educoay/Scoreboard/README.md

# Scoreboard
Arduino powered scoreboard with wired controller

**The wireless branch is newer and currently used in the application**
