educoay/Scoreboard/Scoreboard/README.md

# SCOREBOARD project
### 7-segments diplays scoreboard with wired controller 
**version 1.0.5**

This project is made of a single main C++ file, which will be compiled for Arduino AVR 
architecture, and control a scoreboard with 7-segments display and voltage analog input.
A real application has been developed with this library, showing the score and time in a 
basketball match for a local team. 
Documentation pdf format regarding realization and software can be found in the Doc folder.
Some pictures are at
https://plus.google.com/photos/109652469005118520122/albums/5799213099932281809
