educoay/Scoreboard/Documentation/Schematics/ScoreBoard/Board_S1.png

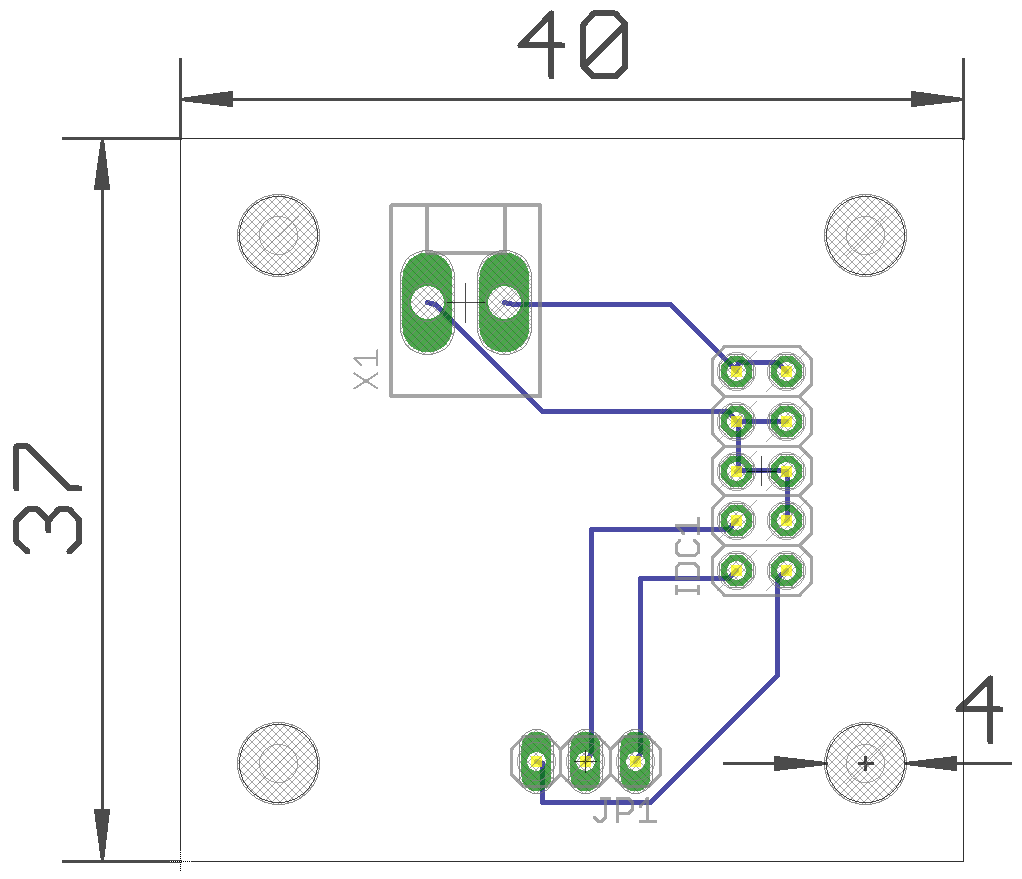
Documentation/Schematics/ScoreBoard/Board_S1.png
