educoay/Scoreboard/(list of files, cad)

Other CAD files:
Documentation/Control panel/Draft/Panel.dwg
Documentation/DataSheet/Console/362-8_Teko.dwg
Documentation/Draft/Scoreboard.dwg
Documentation/Control panel/Draft/Panel_internal.dwg
Documentation/DataSheet/Console/363-8_Teko.dwg
Documentation/Draft/Scoreboard_front.dwg
Documentation/Draft/Scoreboard_back.dwg
