educoay/Scoreboard/Documentation/Control panel/Graphics/Manual.pdf

### HOME

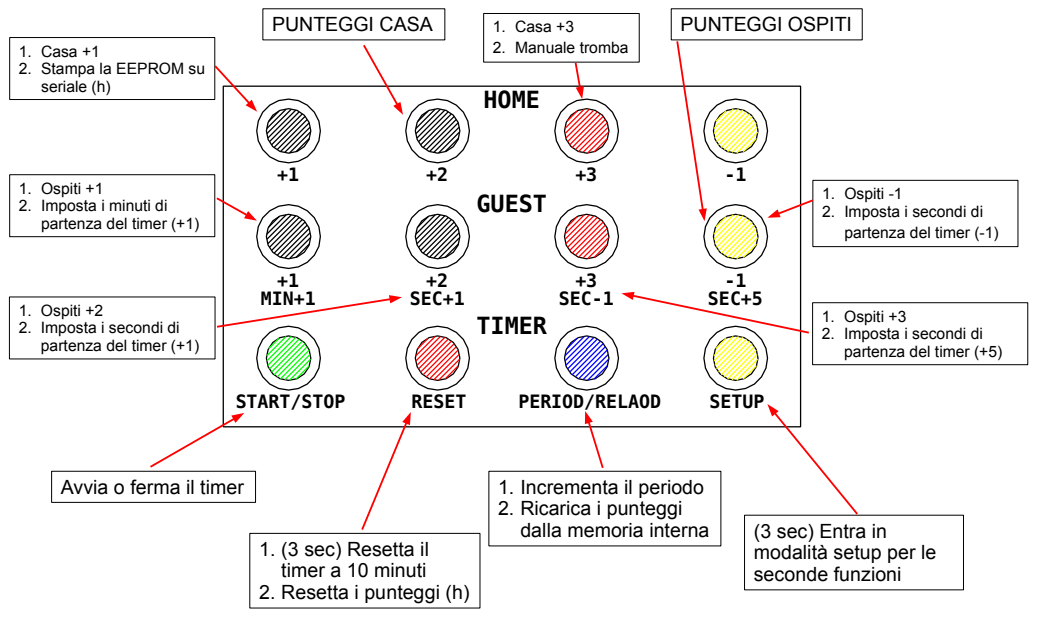
[picture p15: page 1]
START/STOP; RESET; PERIOD/RELAOD; SETUP; MIN+1; SEC+1; SEC-1; SEC+5; GUEST; TIMER; PUNTEGGI CASA; PUNTEGGI OSPITI; dalla memoria interna; (3 sec) Entra in; 1. Casa +3 2. Manuale tromba

1. Casa +1
2. Stampa la EEPROM su
seriale (h)

1. Ospiti +1
2. Imposta i minuti di
partenza del timer (+1)

1. Ospiti -1
2. Imposta i secondi di
partenza del timer (-1)

1. Ospiti +2

1. Ospiti +3
partenza del timer (+5)

Avvia o ferma il timer

1. Incrementa il periodo
2. Ricarica i punteggi

1. (3 sec) Resetta il
timer a 10 minuti
2. Resetta i punteggi (h)

modalità setup per le
seconde funzioni
