educoay/Scoreboard/Documentation/Control panel/Graphics/Manual_volley.pdf

### HOME

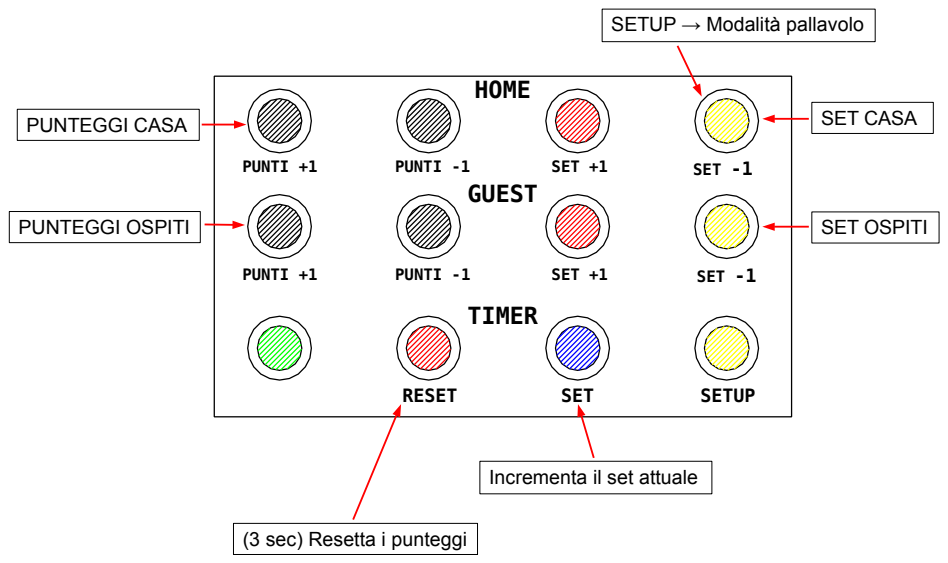
[picture p16: page 1]
PUNTI +1; PUNTI -1; SET +1; SET -1; RESET; SET; SETUP; GUEST; TIMER; PUNTEGGI CASA; PUNTEGGI OSPITI; SET CASA; SET OSPITI

SETUP → Modalità pallavolo

Incrementa il set attuale

(3 sec) Resetta i punteggi
