educoay/Scoreboard/Documentation/Control panel/Graphics/Labels.pdf

### HOME

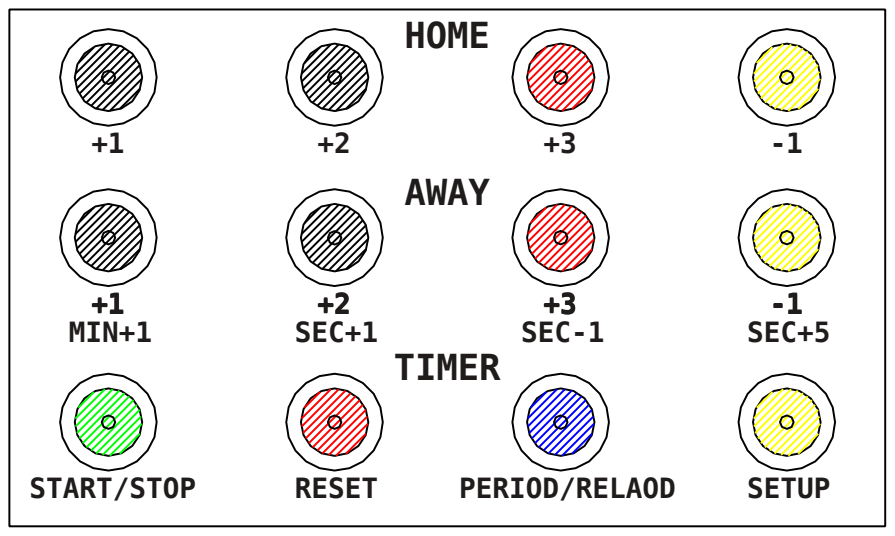
[picture p17: page 1]
START/STOP; RESET; PERIOD/RELAOD; SETUP; MIN+1; SEC+1; SEC-1; SEC+5; AWAY; TIMER
