educoay/Scoreboard/Documentation/Schematics/ScoreBoard/Board_S1_sche.pdf

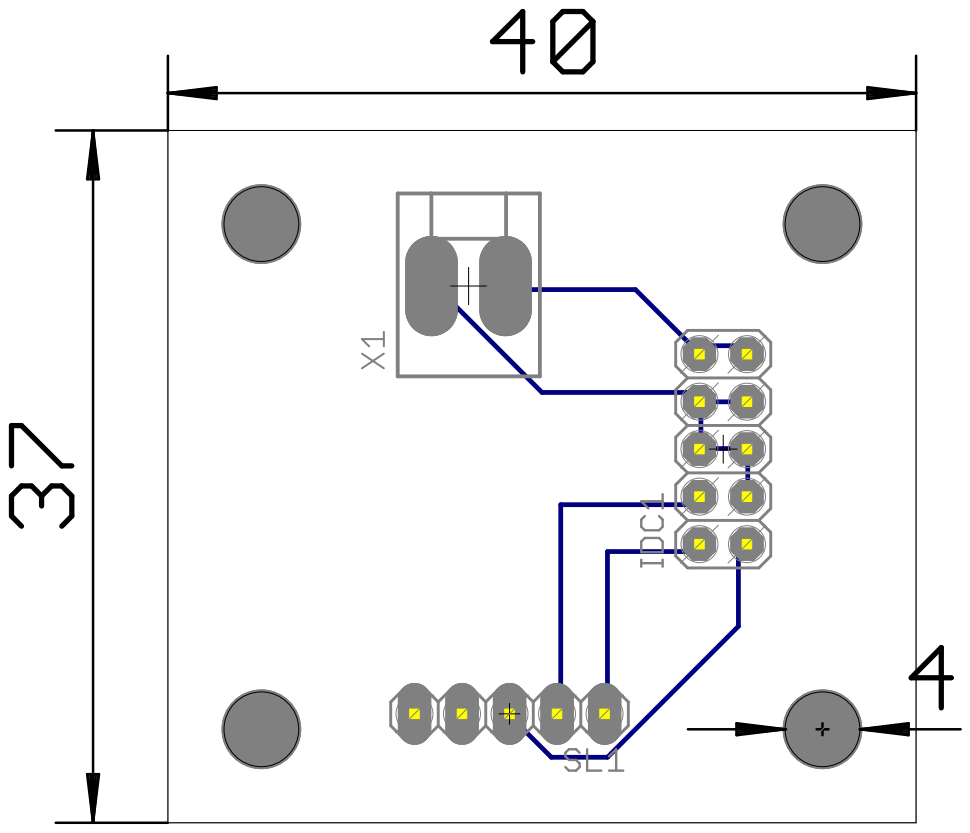
[picture p18: page 1]
