educoay/Scoreboard/Documentation/Schematics/ScoreBoard/Board_S1_sche_M.pdf

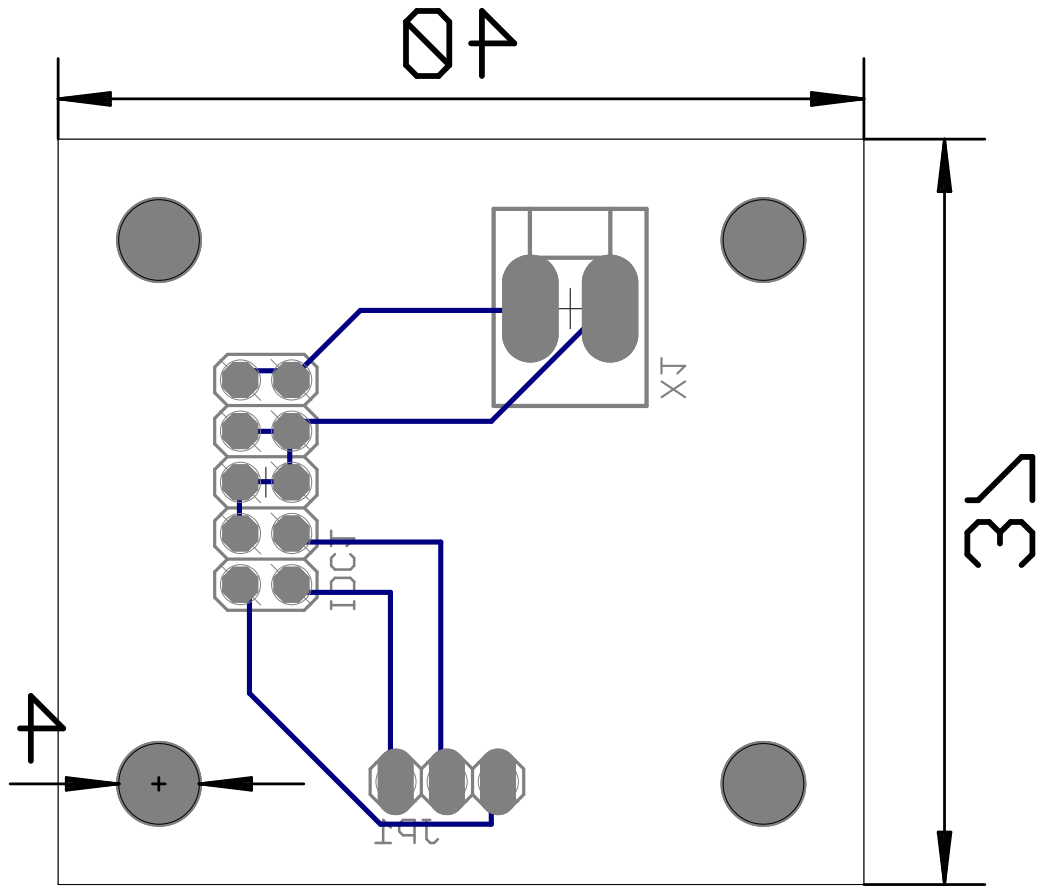
[picture p19: page 1]
