educoay/Scoreboard/Documentation/Schematics/ScoreBoard/BuzzerSchematic.pdf

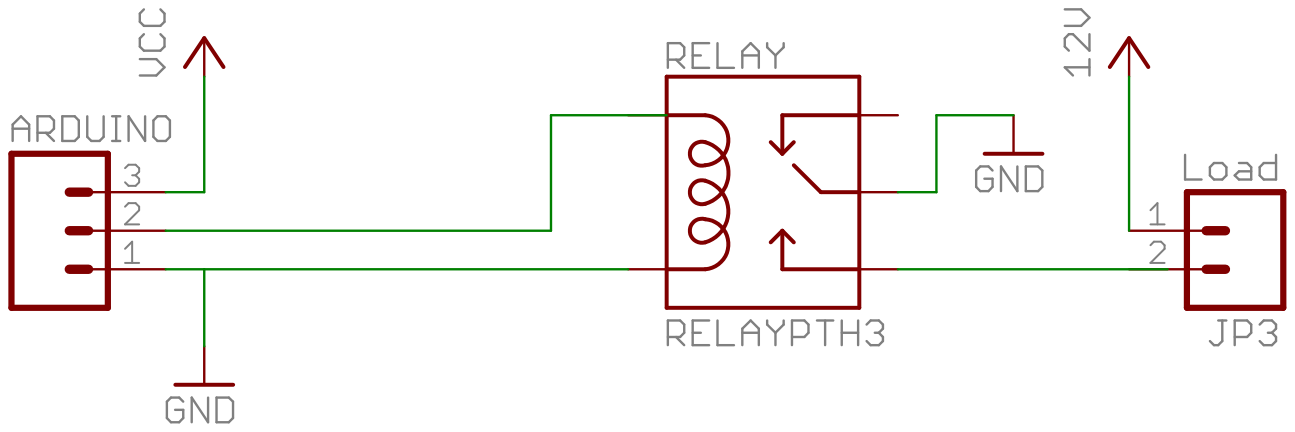
[picture p20: page 1]
