educoay/Scoreboard/Documentation/Schematics/ScoreBoard/decoupling.pdf

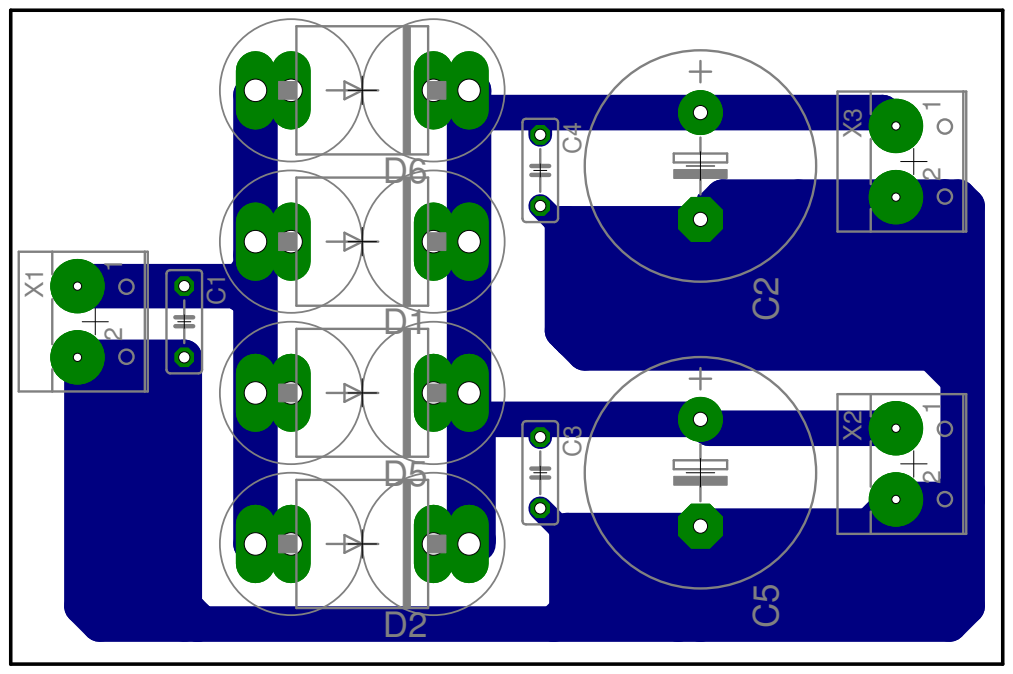
[picture p21: page 1]
