educoay/Scoreboard/Documentation/Schematics/ScoreBoard/decoupling_M.pdf

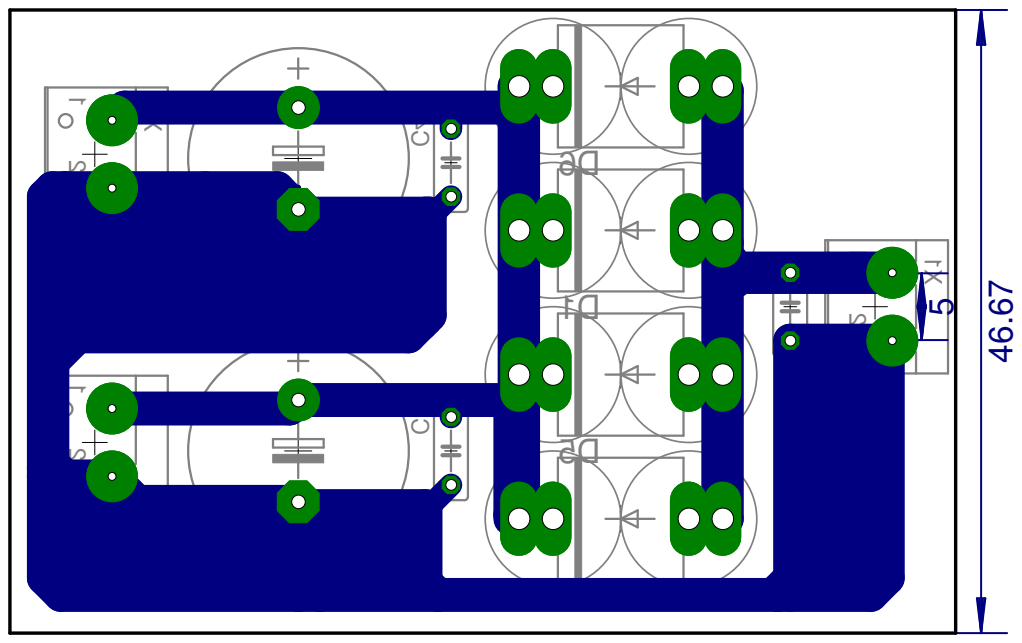
[picture p22: page 1]
