educoay/Scoreboard/Documentation/Schematics/ScoreBoard/Main.pdf

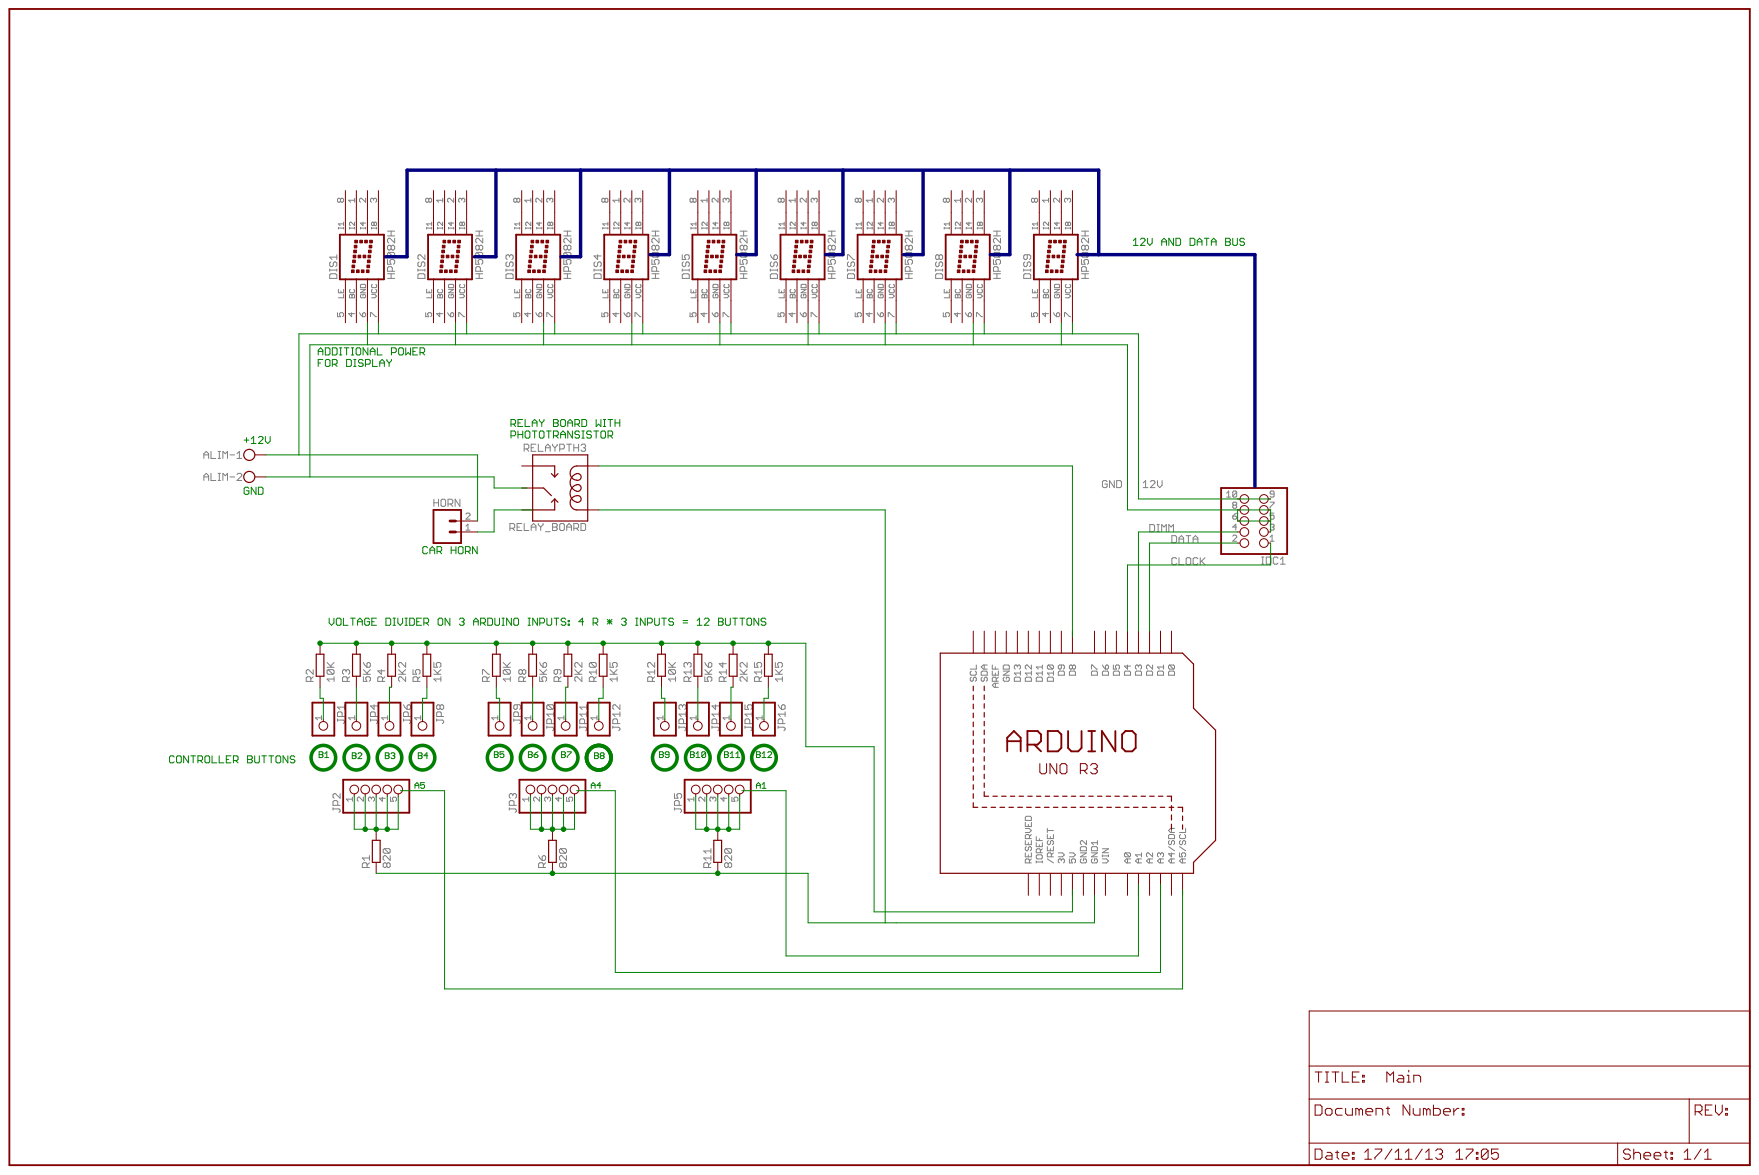
[picture p23: page 1]
