educoay/Scoreboard/Documentation/Schematics/ScoreBoard/Panel.pdf

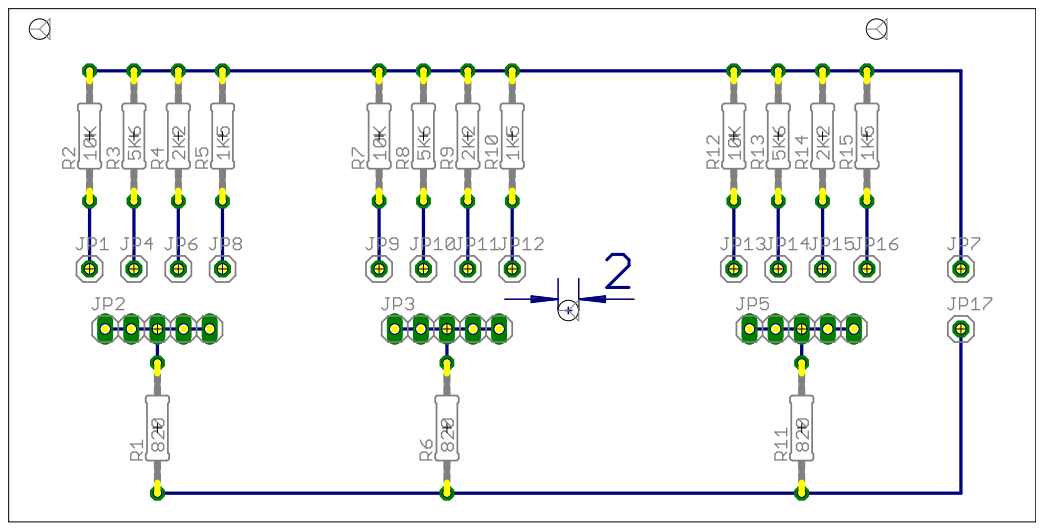
[picture p24: page 1]
