educoay/Scoreboard/Documentation/Schematics/ScoreBoard/Panel_M.pdf

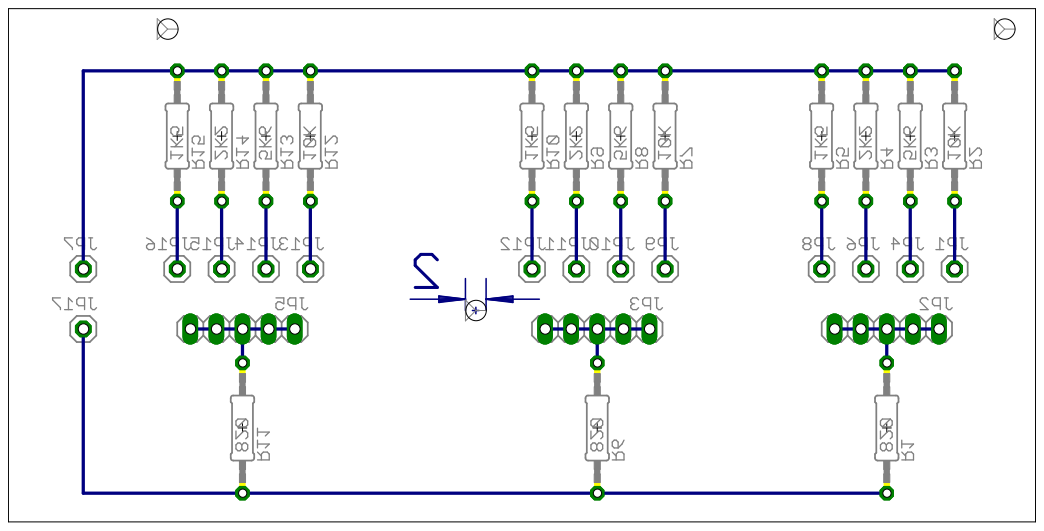
[picture p25: page 1]
