educoay/Scoreboard/Documentation/Graphics/prespaziati.pdf

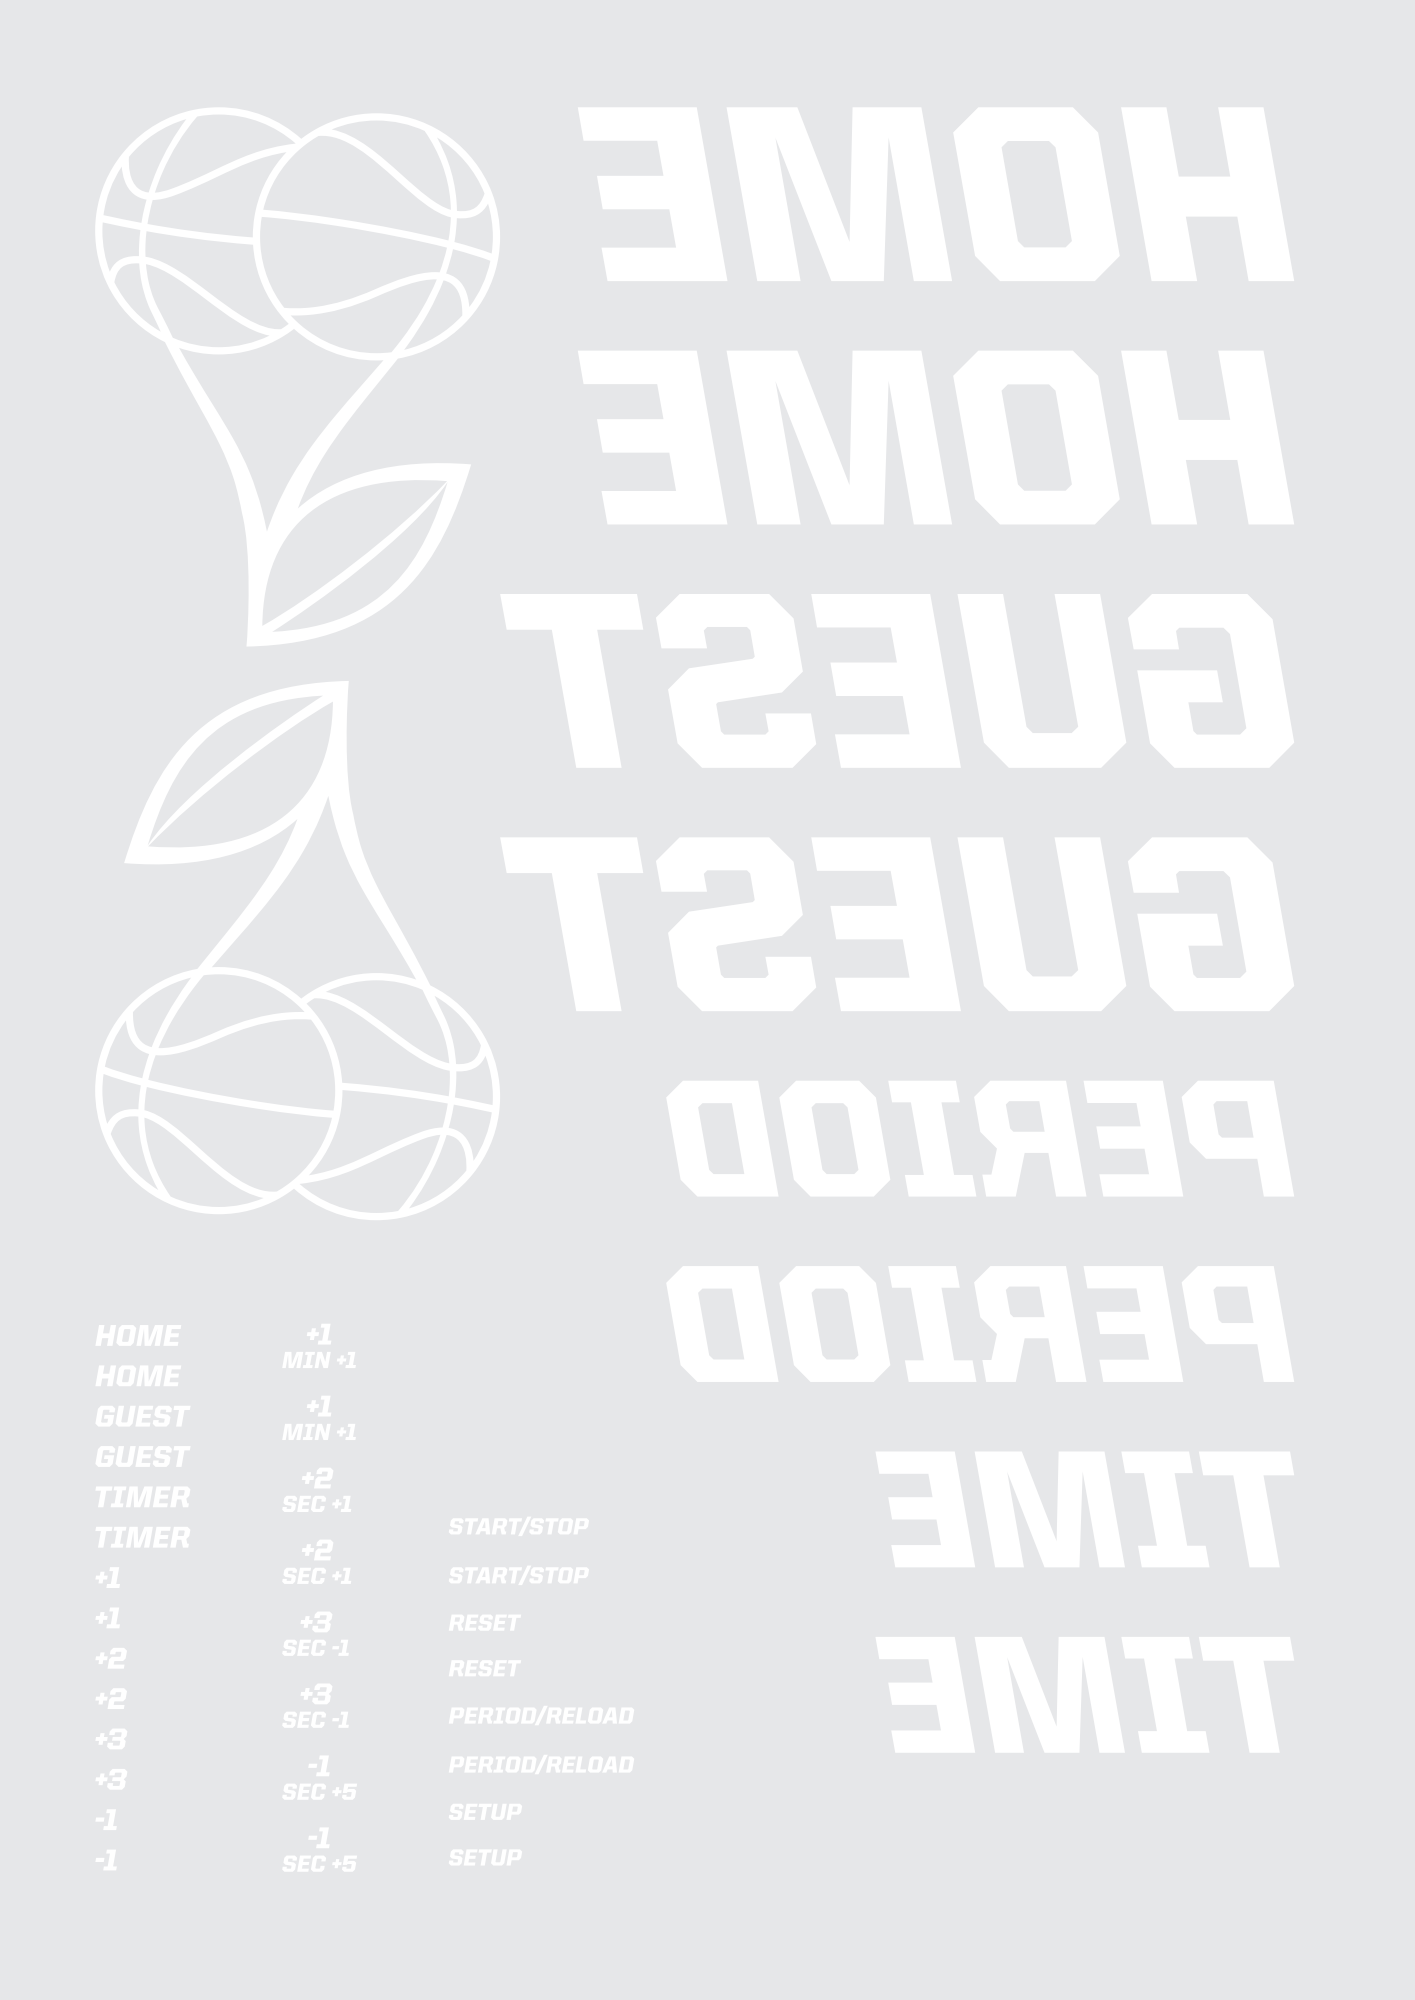
[picture p26: page 1]
