educoay/Scoreboard/Documentation/Graphics/Scoreboard_front+stickers.pdf

## HOME

## GUEST

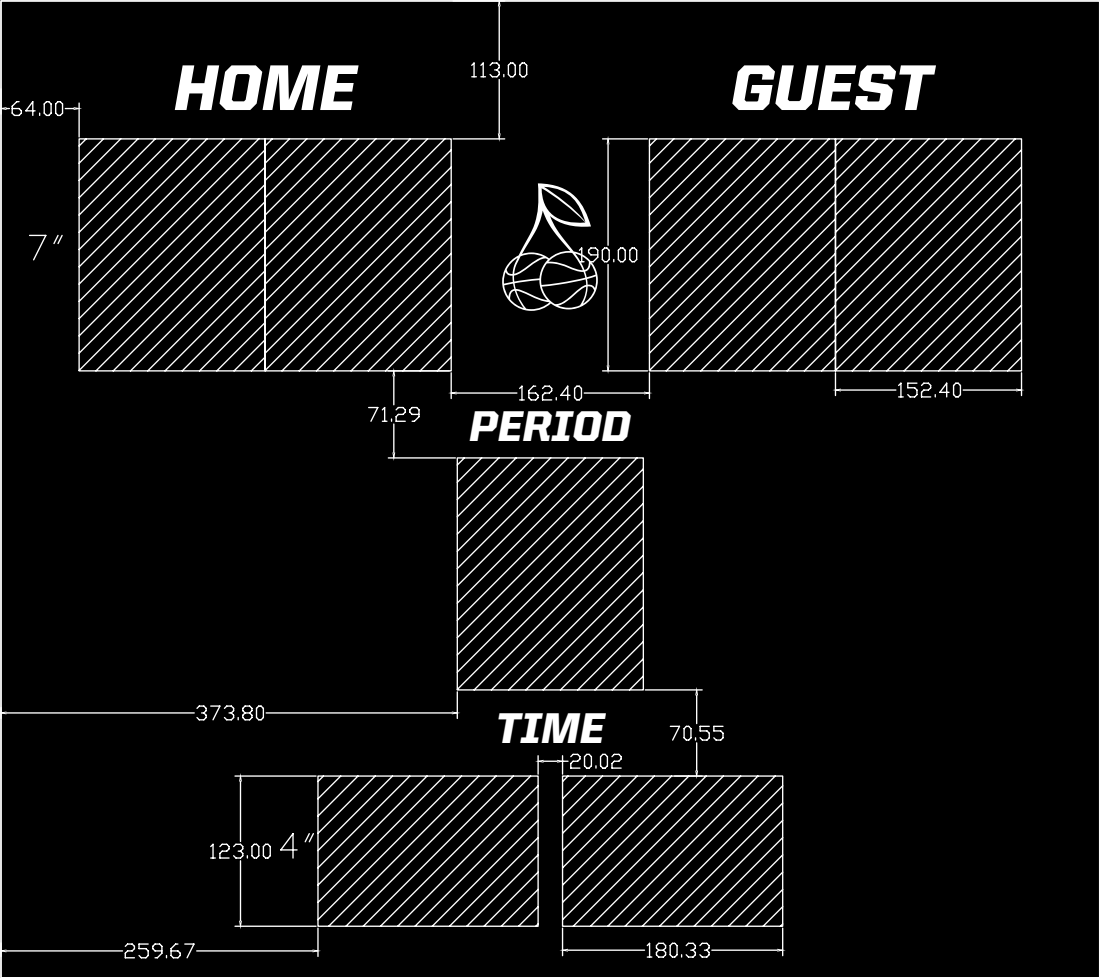
[picture p27: page 1]
PERIOD; TIME
