educoay/Scoreboard/Documentation/Draft/Scoreboard.pdf

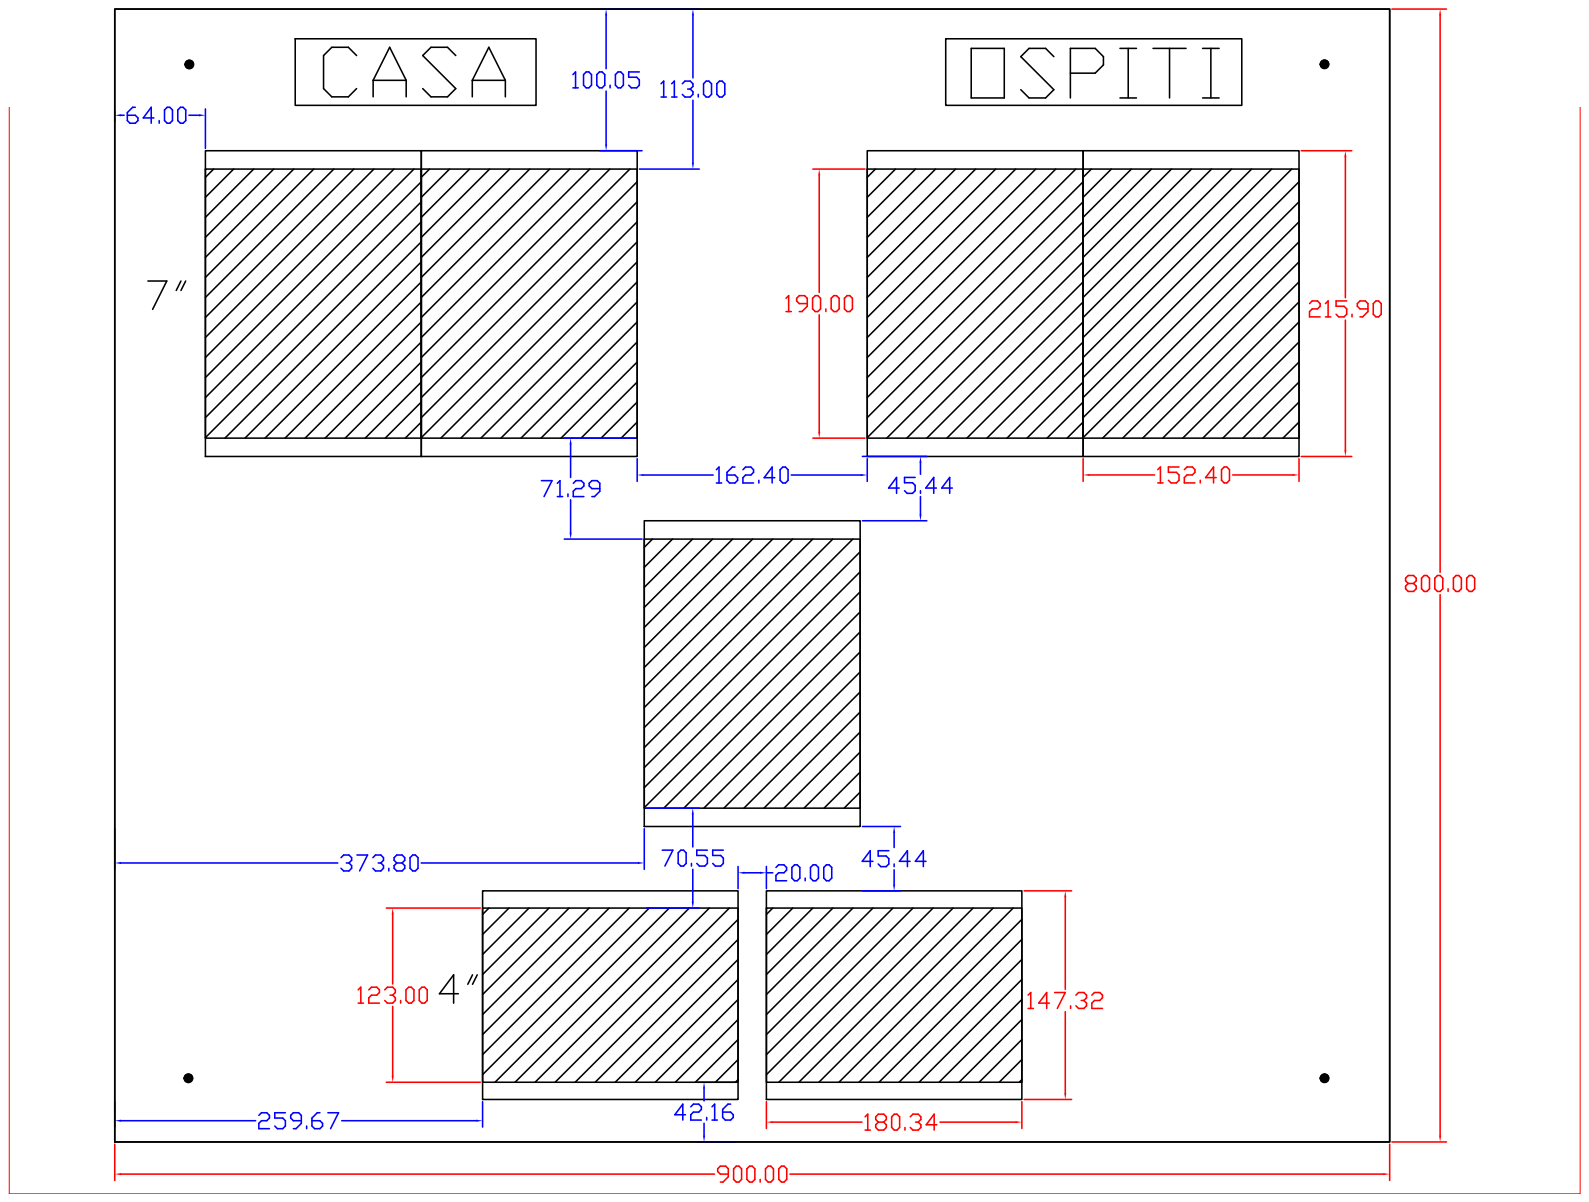
[picture p28: page 1]
