educoay/Scoreboard/Documentation/Draft/Scoreboard_back.pdf

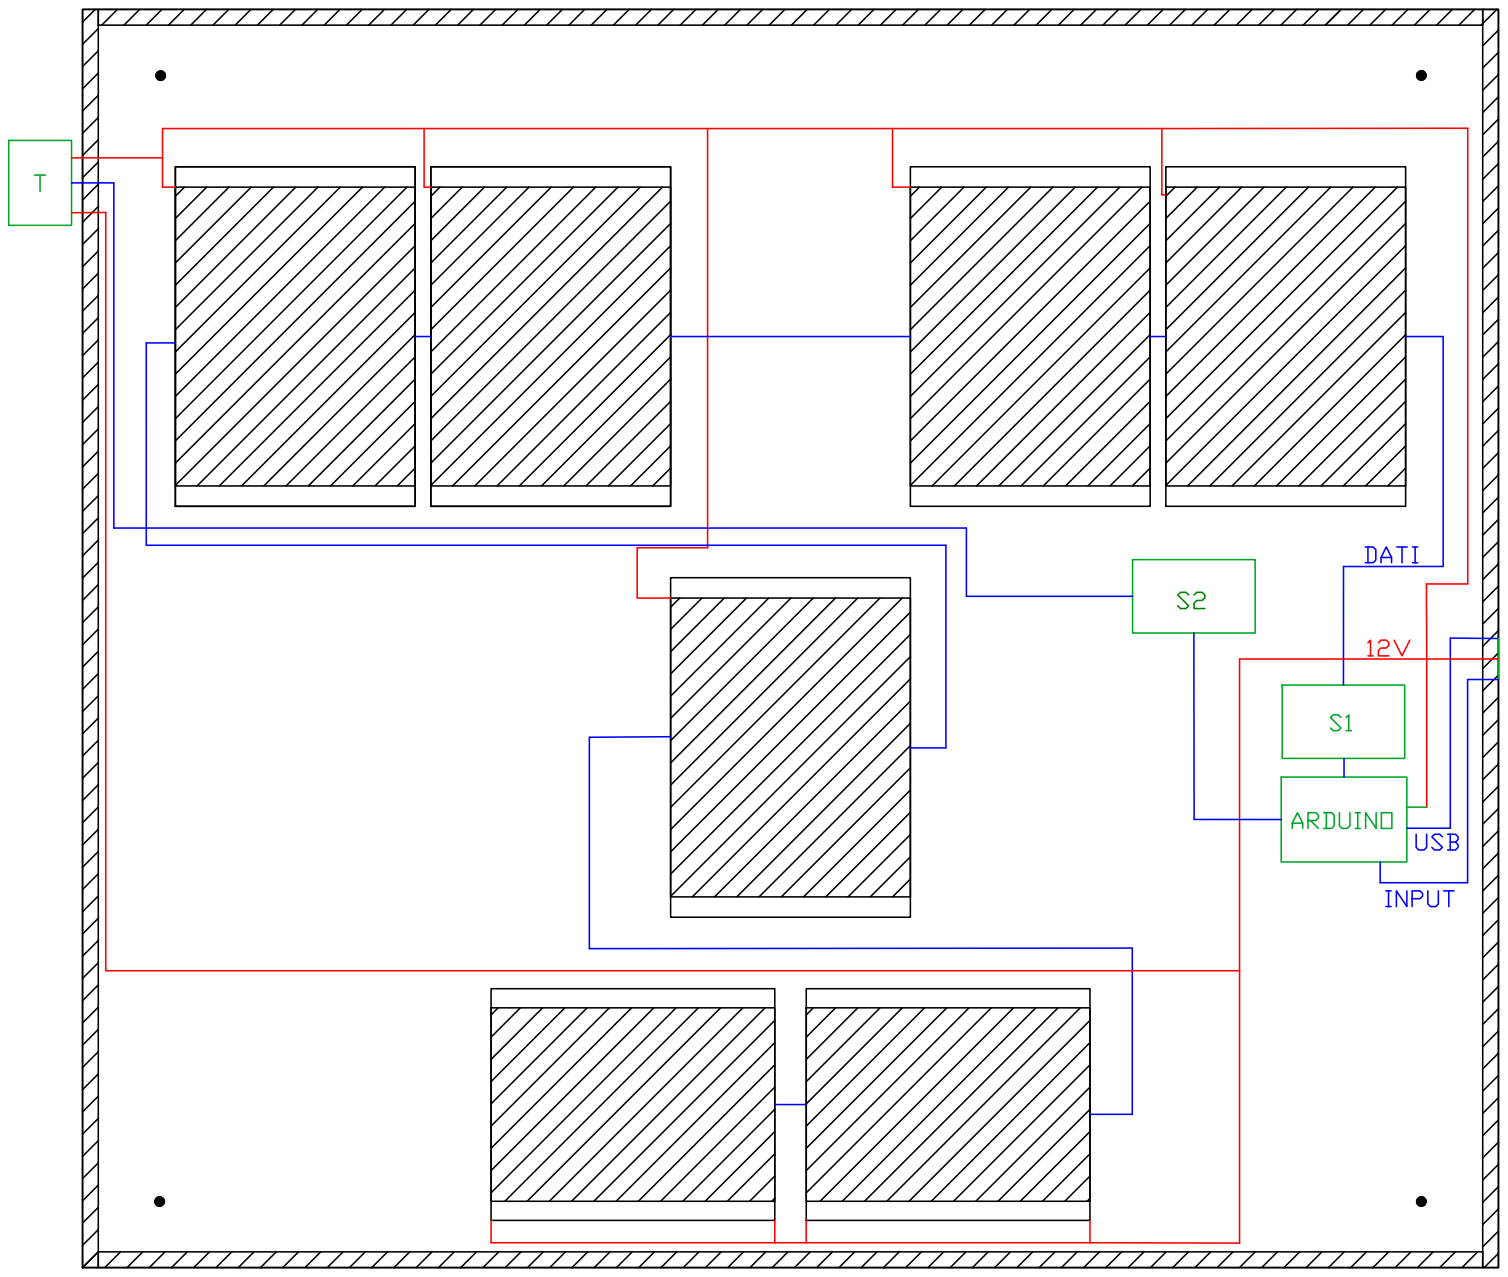
[picture p29: page 1]
