educoay/Scoreboard/Documentation/Draft/Scoreboard_front.pdf

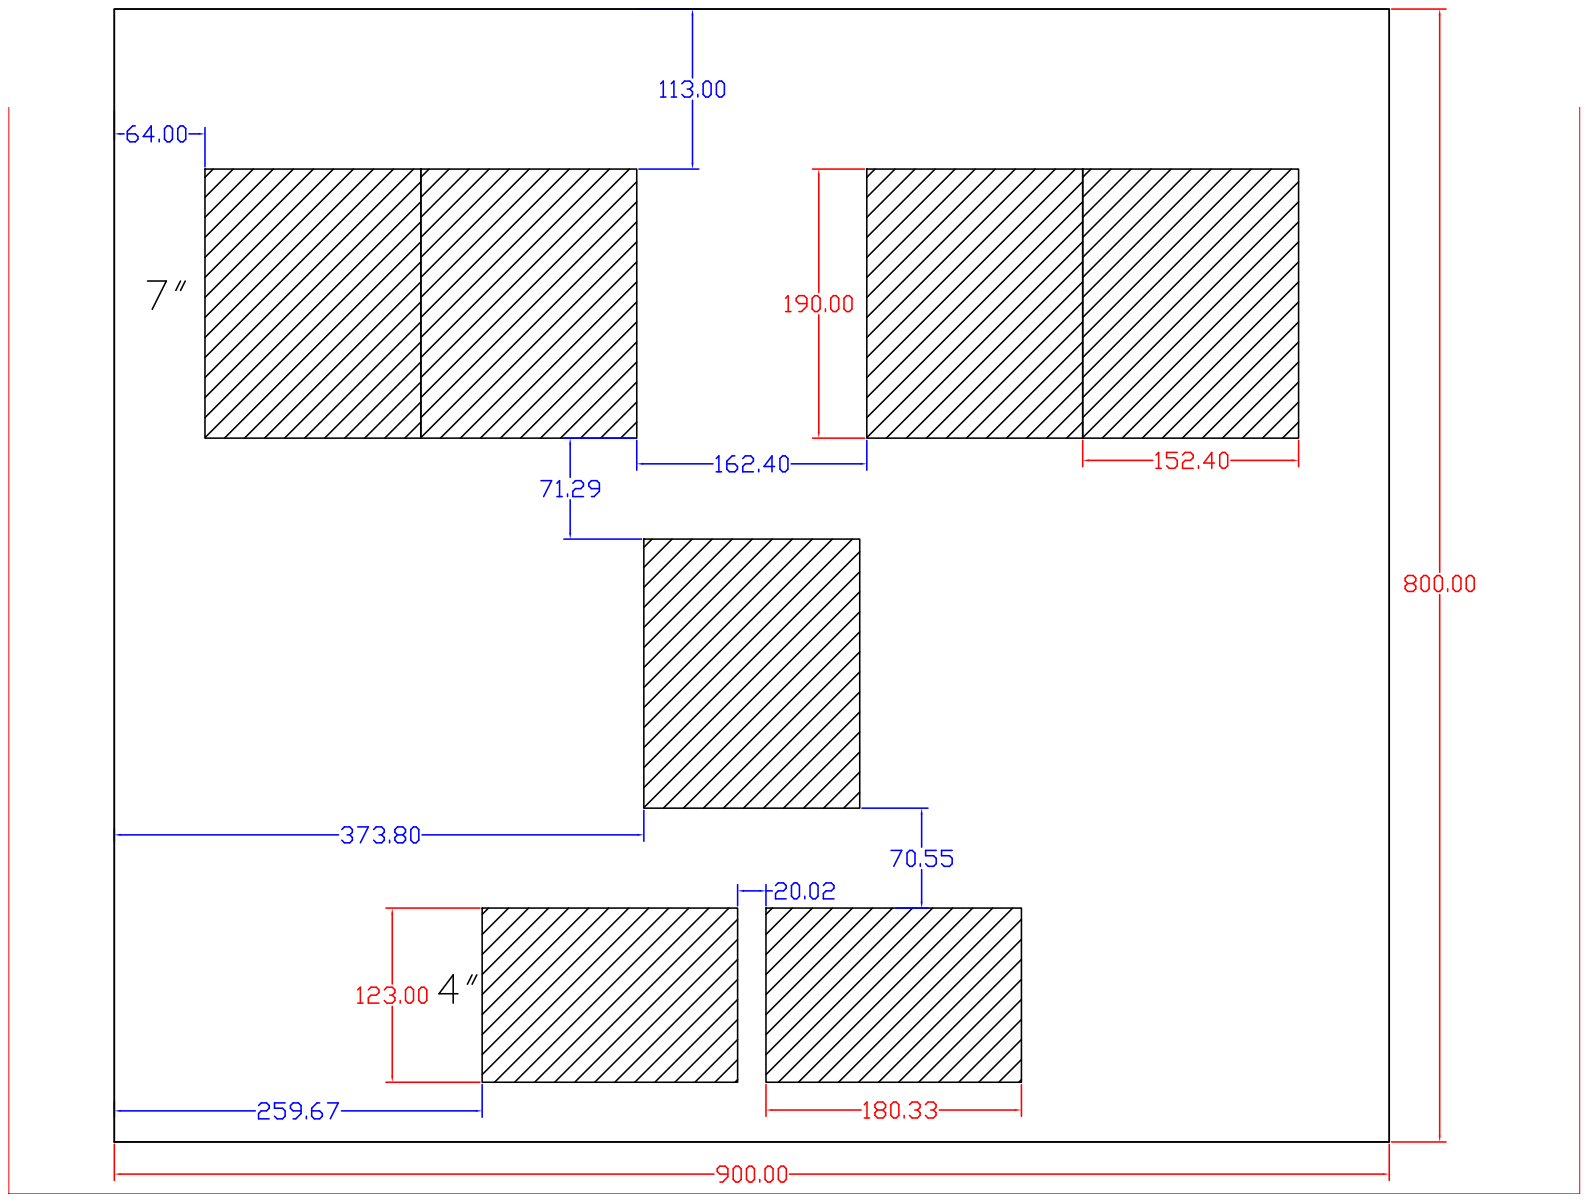
[picture p30: page 1]
