educoay/Scoreboard/Documentation/Control panel/Draft/Panel.pdf

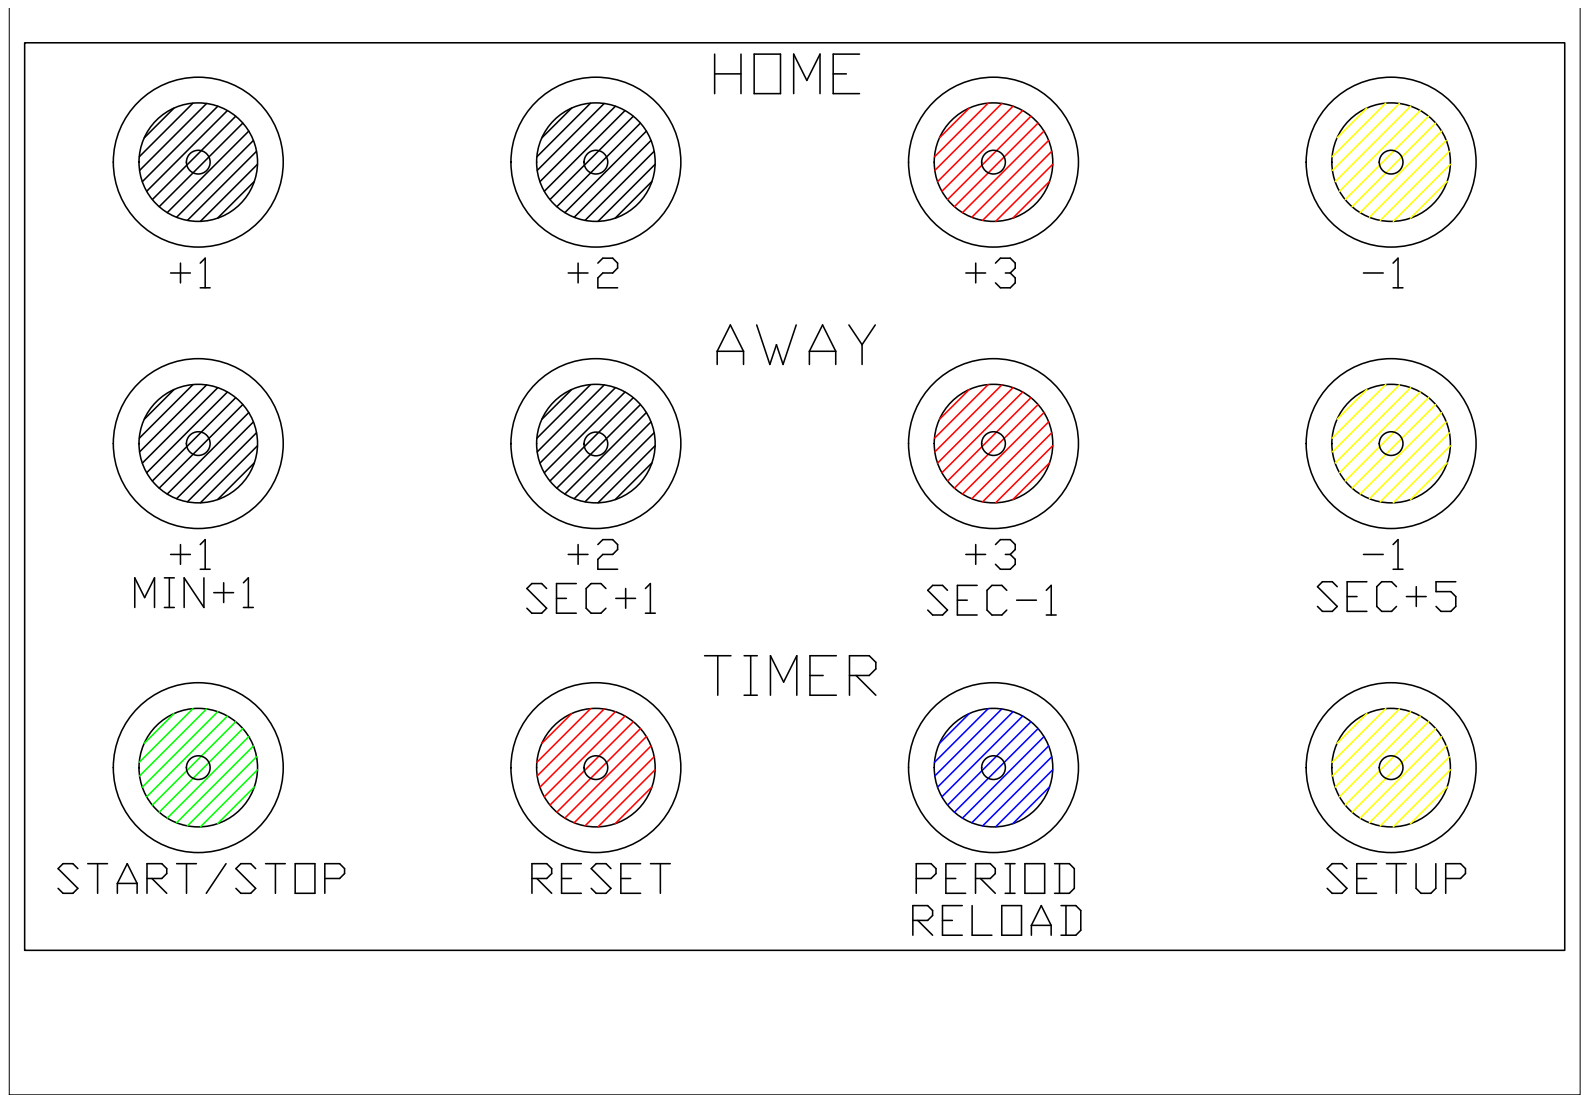
[picture p31: page 1]
