educoay/Scoreboard/Documentation/Control panel/Draft/Panel_dimension.pdf

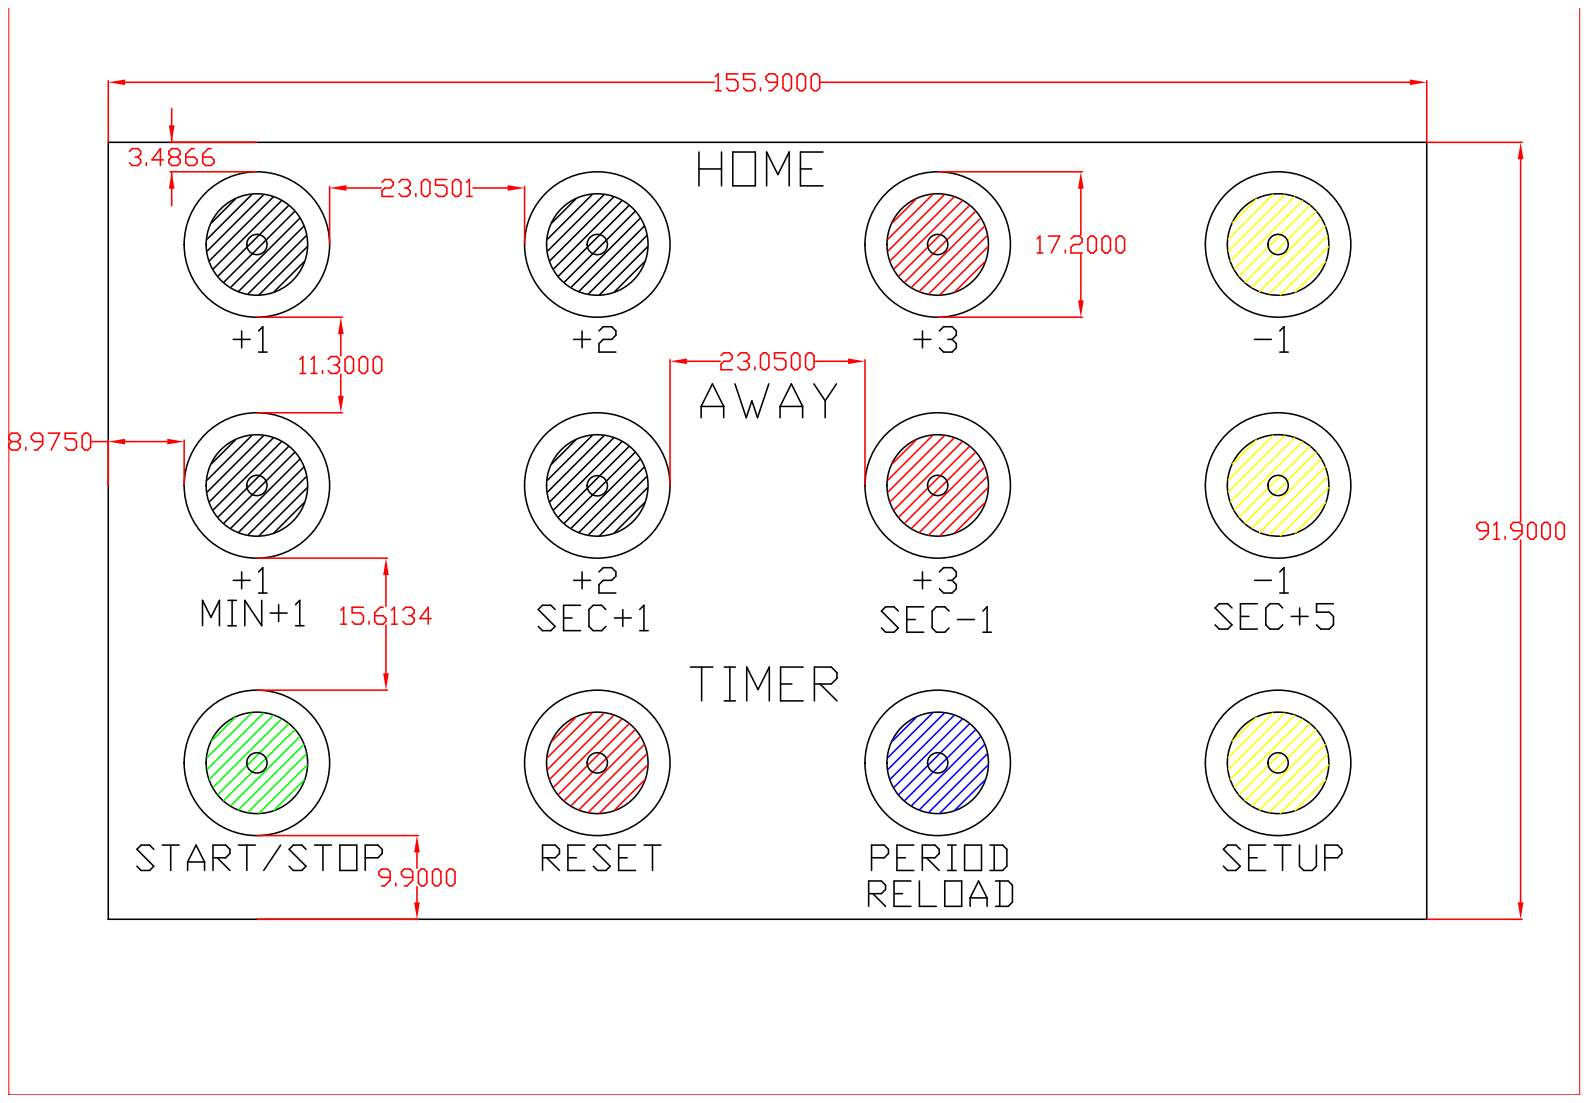
[picture p32: page 1]
