educoay/Scoreboard/Documentation/Control panel/Draft/Panel_internal.pdf

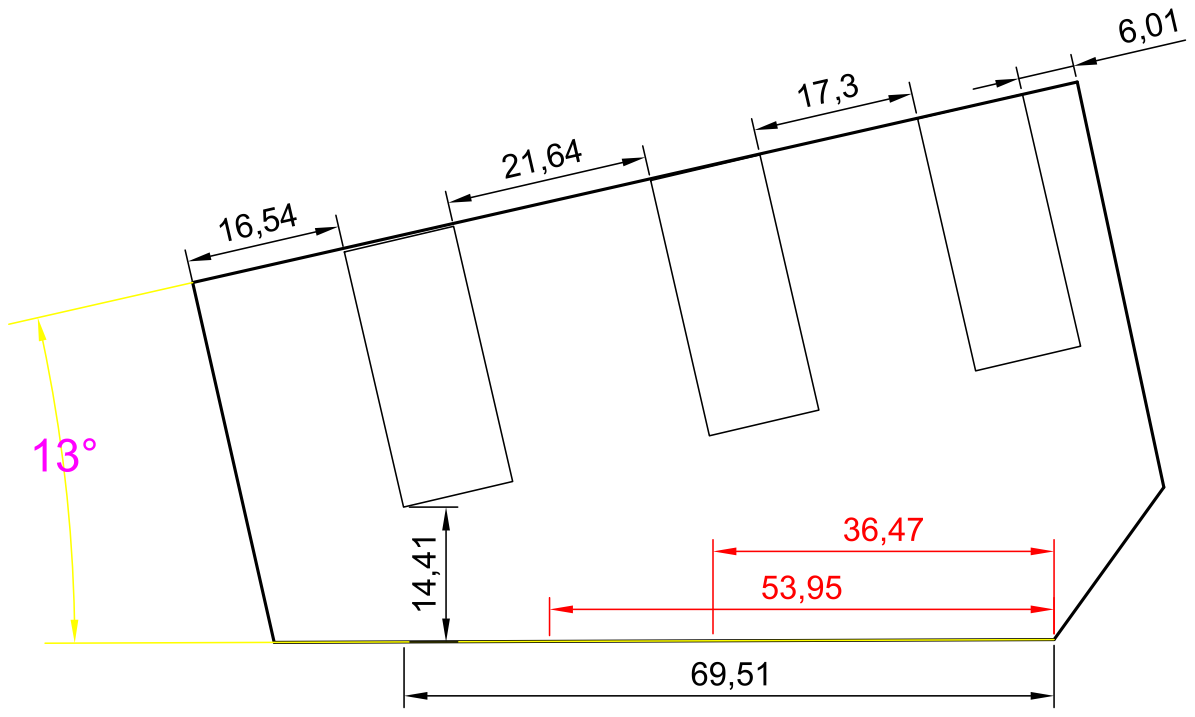
[picture p33: page 1]
