educoay/Scoreboard/Documentation/Control panel/Graphics/Labels+stickers.pdf

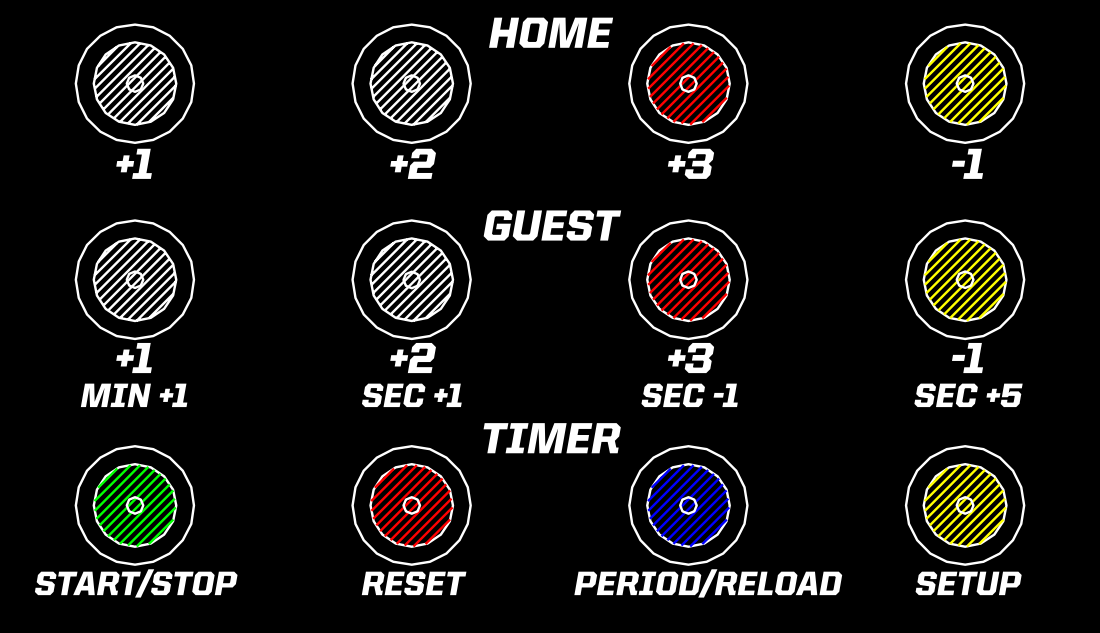
[picture p34: page 1]
