educoay/Scoreboard/Documentation/Schematics/ScoreBoard/Board_S1_sche.brd

## EAGLE design Documentation/Schematics/ScoreBoard/Board_S1_sche.brd (2015-11-08)

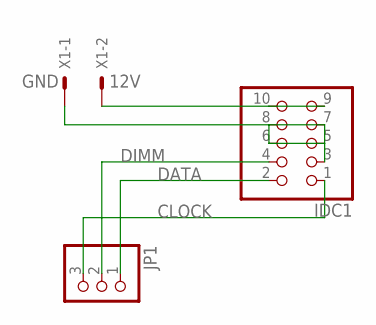
[picture p35: schematic Board_S1_sche.sch]

Parts:
IDC1: PINHD-2X5; 2X05
JP1: PINHD-1X3; 1X03
X1: KK-156-2

Connections:
12V: IDC1.9, IDC1.10, X1.2
CLOCK: IDC1.1, JP1.3
DATA: IDC1.2, JP1.1
DIMM: IDC1.4, JP1.2
GND: IDC1.3, IDC1.5, IDC1.6, IDC1.7, IDC1.8, X1.1

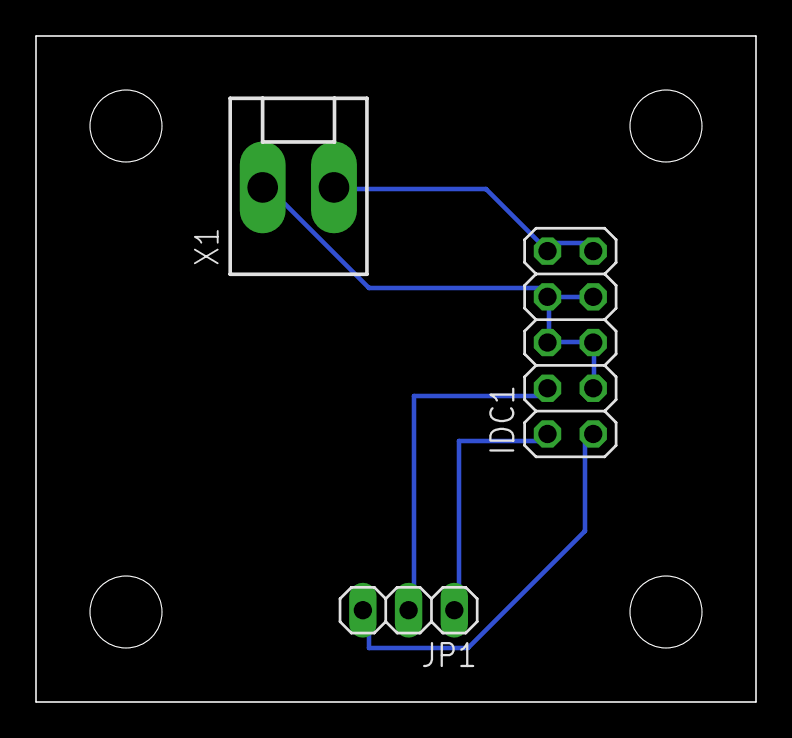
[picture p36: board Board_S1_sche.brd from above]

Board: 2 copper layers, 40.0 x 37.0 mm, 3 parts (0 on the bottom side), 5 nets.
