educoay/Scoreboard/Documentation/Schematics/ScoreBoard/Panel.brd

## EAGLE design Documentation/Schematics/ScoreBoard/Panel.brd (2015-11-08)

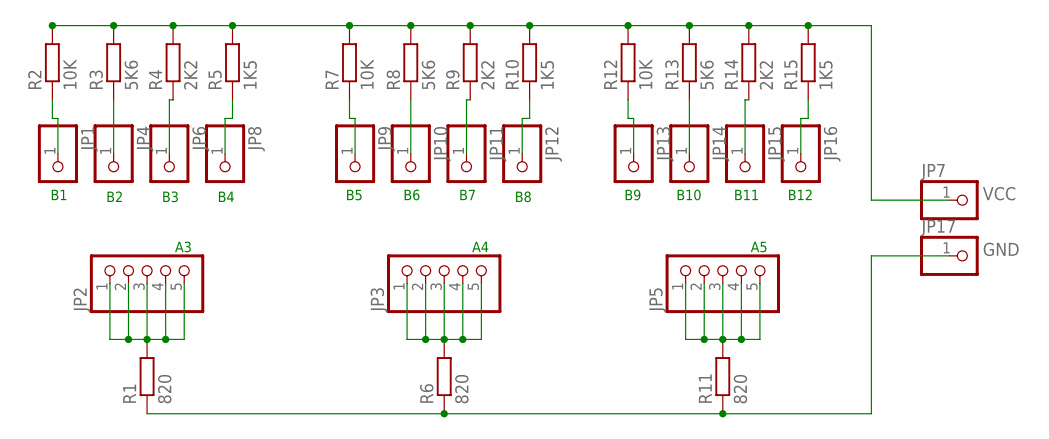
[picture p37: schematic Panel.sch]

Parts:
JP1, JP4, JP6, JP7, JP8, JP9, JP10, JP11, JP12, JP13, JP14, JP15, JP16, JP17: PINHD-1X1; 1X01
JP2, JP3, JP5: PINHD-1X5; 1X05
R1, R6, R11: 820; 0207/12
R2, R7, R12: 10K; 0207/12
R3, R8, R13: 5K6; 0207/12
R4, R9, R14: 2K2; 0207/12
R5, R10, R15: 1K5; 0207/12

Connections:
A1: JP3.1, JP3.2, JP3.3, JP3.4, JP3.5, R6.2
A2: JP5.1, JP5.2, JP5.3, JP5.4, JP5.5, R11.2
A3: JP2.1, JP2.2, JP2.3, JP2.4, JP2.5, R1.2
B1: JP1.1, R2.1
B2: JP4.1, R3.1
B3: JP6.1, R4.1
B4: JP8.1, R5.1
B5: JP9.1, R7.1
B6: JP10.1, R8.1
B7: JP11.1, R9.1
B8: JP12.1, R10.1
B9: JP13.1, R12.1
B10: JP14.1, R13.1
B11: JP15.1, R14.1
B12: JP16.1, R15.1
GND: JP17.1, R1.1, R6.1, R11.1
VCC: JP7.1, R2.2, R3.2, R4.2, R5.2, R7.2, R8.2, R9.2, R10.2, R12.2, R13.2, R14.2, R15.2

Notes on the sheet:
B10
B11
B12

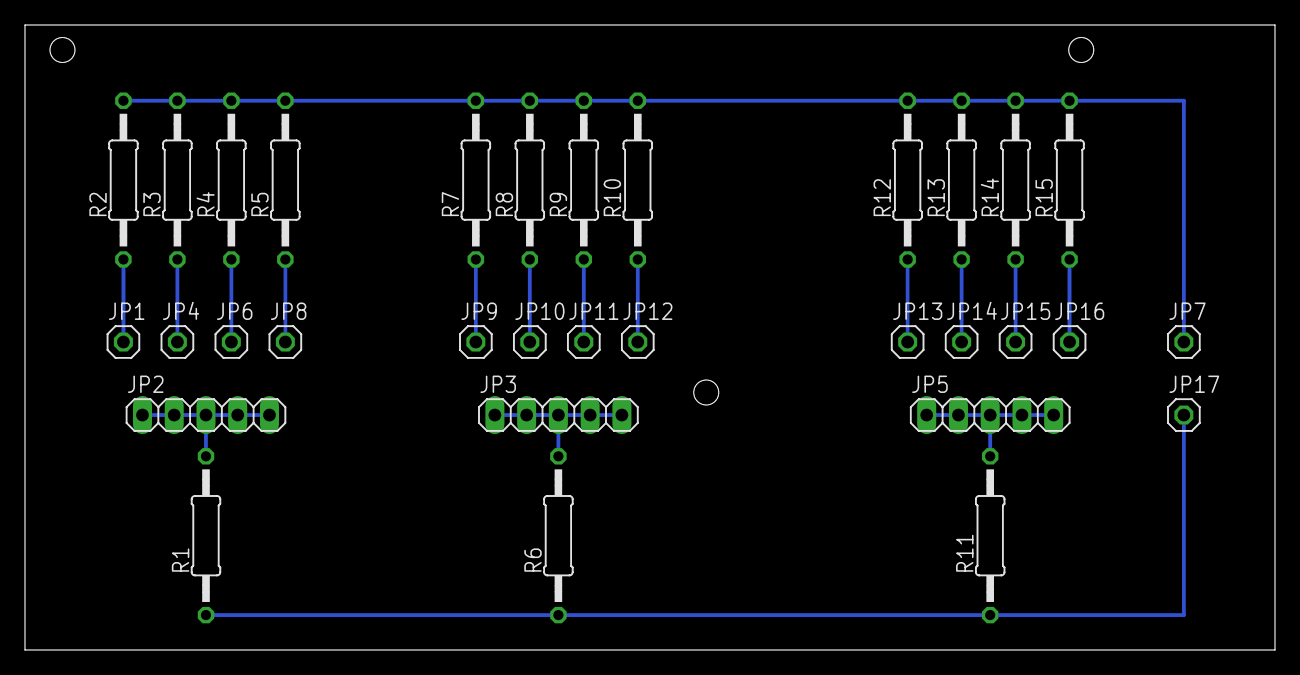
[picture p38: board Panel.brd from above]

Board: 2 copper layers, 100.0 x 50.0 mm, 32 parts (0 on the bottom side), 17 nets.
