educoay/Scoreboard/Documentation/Schematics/ScoreBoard/decoupling.brd

## EAGLE design Documentation/Schematics/ScoreBoard/decoupling.brd (2015-11-08)

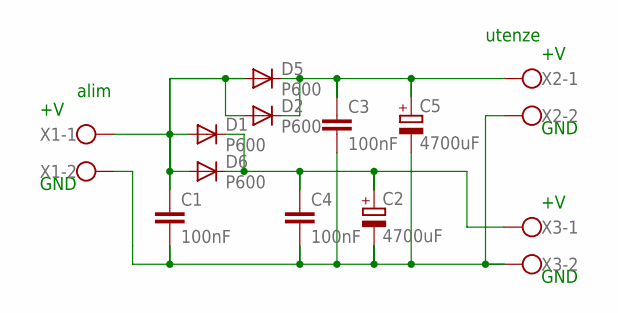
[picture p39: schematic decoupling.sch]

Parts:
C1, C3, C4: 100nF; C050-025X075
C2, C5: 4700uF; E7,5-16
D1, D2, D5, D6: P600; P6-15
X1, X2, X3: W237-102

Connections:
unnamed: C1.2, C2.-, C3.2, C4.2, C5.-, X1.2, X2.2, X3.2
unnamed: C1.1, D1.A, D2.A, D5.A, D6.A, X1.1
unnamed: C2.+, C4.1, D1.C, D6.C, X3.1
unnamed: C3.1, C5.+, D2.C, D5.C, X2.1

Notes on the sheet:
alim
utenze
GND

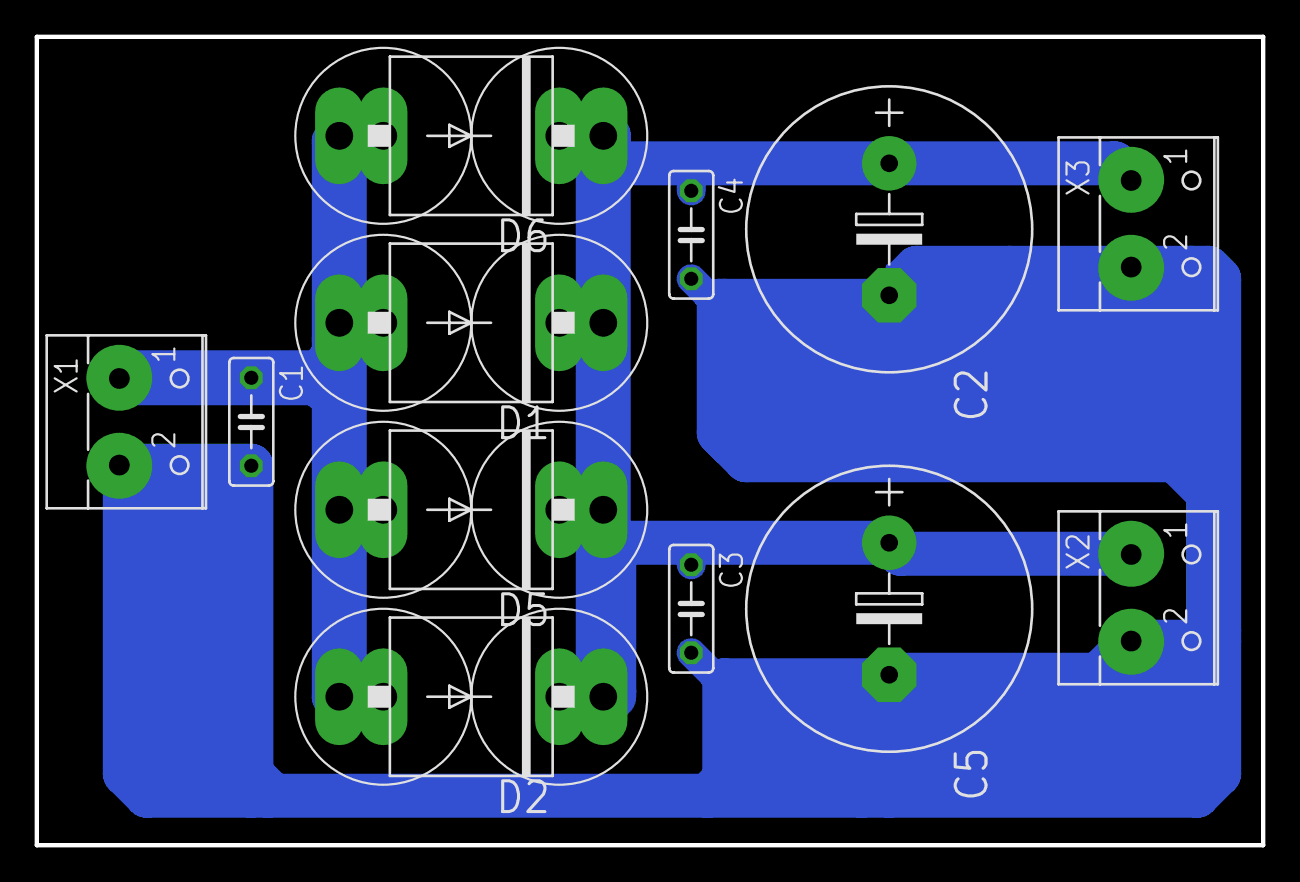
[picture p40: board decoupling.brd from above]

Board: 2 copper layers, 70.8 x 46.7 mm, 12 parts (0 on the bottom side), 4 nets.
