educoay/Scoreboard/(commit log)

2015-01-25 Initial import of Eclispe projects: to read analog buttons, manage 7-seg displays and the main application
2015-01-25 Change in README for this main branch (wired)
2015-11-08 Added Documentation folder, only some file as a test
    [Preventivo.ods]
2015-11-08 Added scoreboard and control panel drafts in Doc folder
    [Panel.dwg, Panel_internal.dwg, Scoreboard.dwg, Scoreboard_back.dwg, Scoreboard_front.dwg]
2015-11-08 Added grapichs and schematics in Doc folder
    [Board_S1_sche.brd, Board_S1_sche.sch, BuzzerSchematic.sch, Main.sch, Main_f.sch, Panel.brd, Panel.sch, decoupling.brd]
2015-11-08 Added datasheet of components in Doc folder
    [362-8_Teko.dwg, 363-8_Teko.dwg]
2016-12-20 Updated project path, changed AnalogButtons library with general version: the analog value is passed to the checkValue() function, to avoid reference to the analogRead() in the library.
    [main.cpp]
